TeamAntumbra/glow-hardware/Beta Release/Electronics/AntumbraBetaBoard.jpg

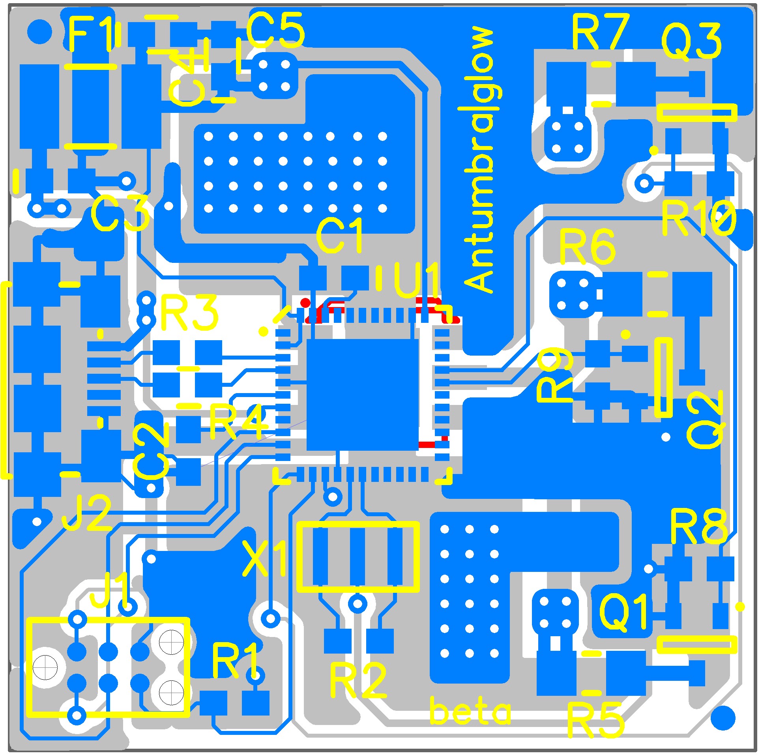
Beta Release/Electronics/AntumbraBetaBoard.jpg
