TeamAntumbra/glow-hardware/Beta Release/Electronics/AntumbraBetaSchematic.jpg

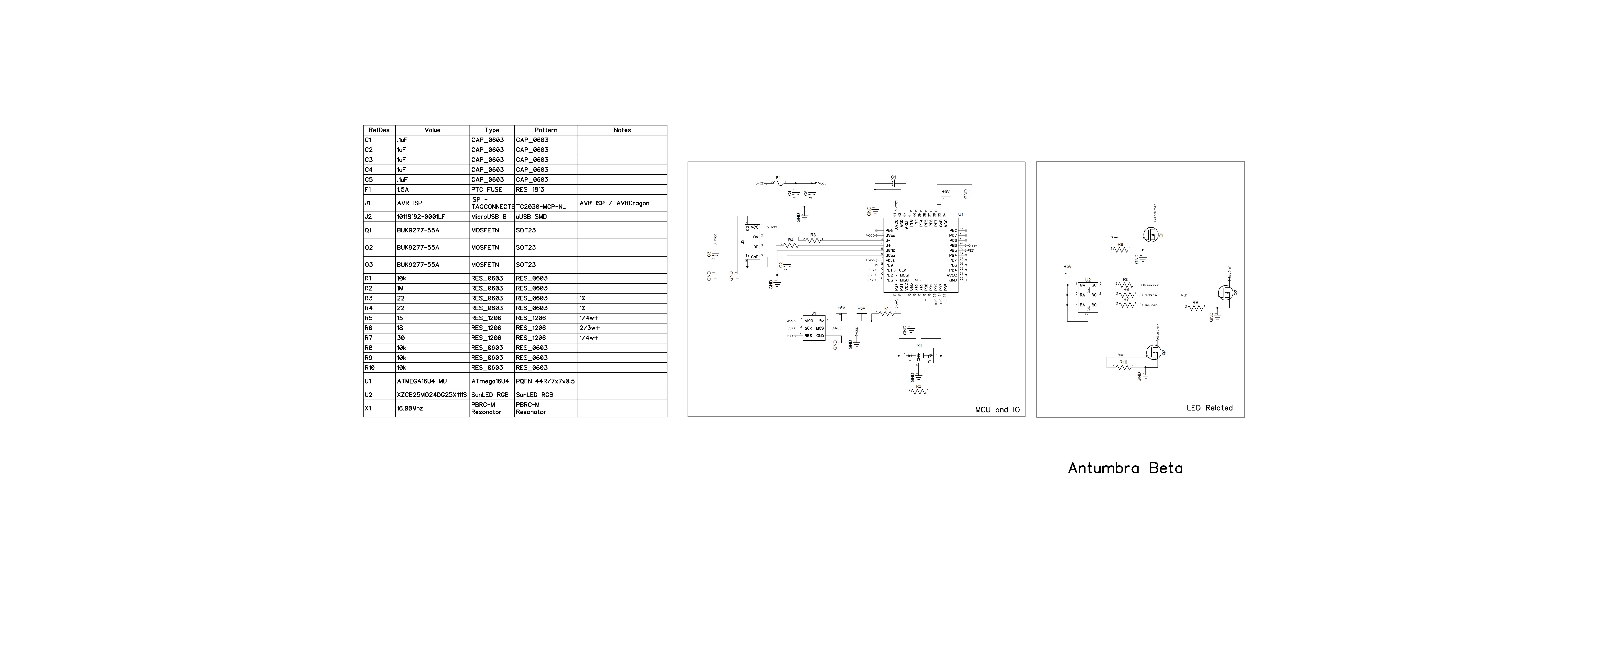
Beta Release/Electronics/AntumbraBetaSchematic.jpg
