TeamAntumbra/glow-hardware/Beta Release/Mechanical Production Files/Back View Hardware.JPG

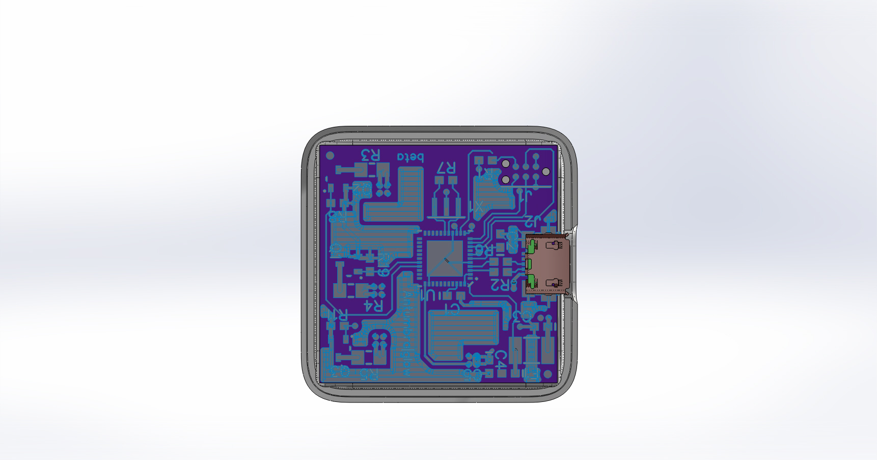
Beta Release/Mechanical Production Files/Back View Hardware.JPG
