TeamAntumbra/glow-hardware/Beta Release/Mechanical Production Files/Side Cutaway Hardware.JPG

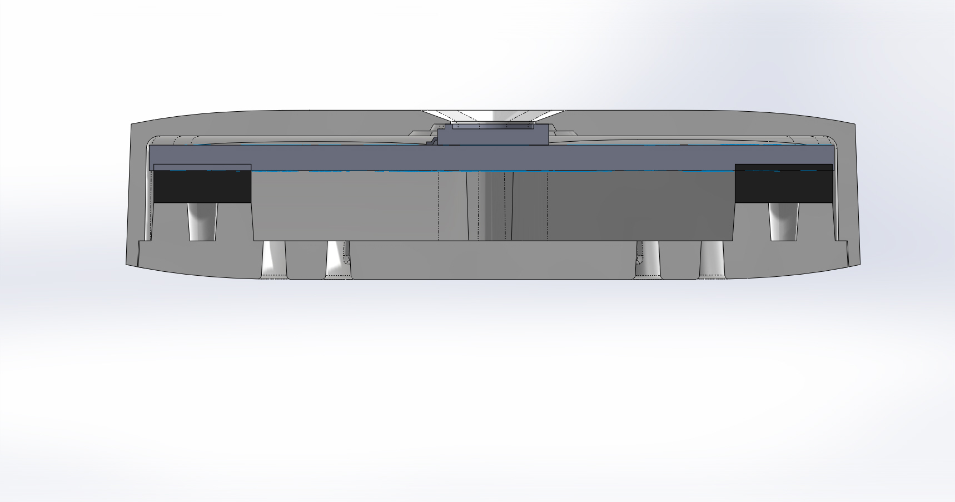
Beta Release/Mechanical Production Files/Side Cutaway Hardware.JPG
