TeamAntumbra/glow-hardware/Beta Release/Mechanical Production Files/Trimetric Hardware.JPG

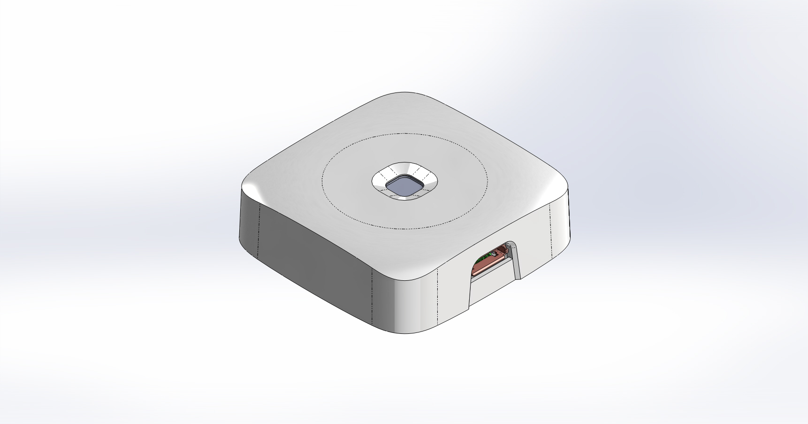
Beta Release/Mechanical Production Files/Trimetric Hardware.JPG
