TeamAntumbra/glow-hardware/Beta Release/Mechanical Production Files/Main Body.STL

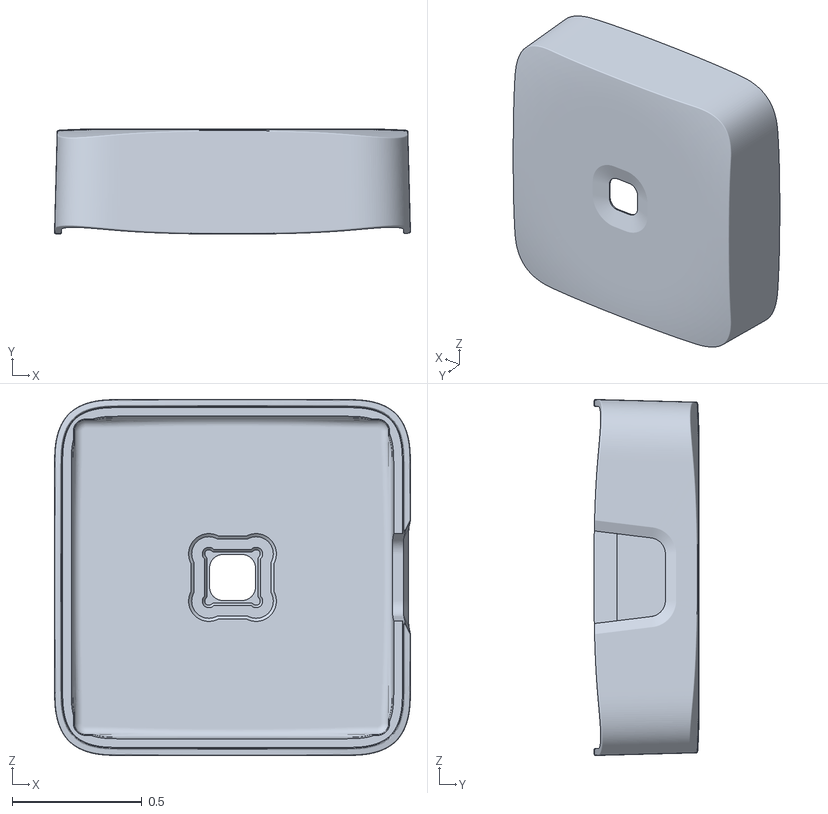
[picture p6: CAD file, 2015-02-19]
Beta Release/Mechanical Production Files/Main Body.STL
1.37 x 0.406 x 1.37
