TeamAntumbra/glow-hardware/Beta Release/Mechanical Production Files/Base.STL

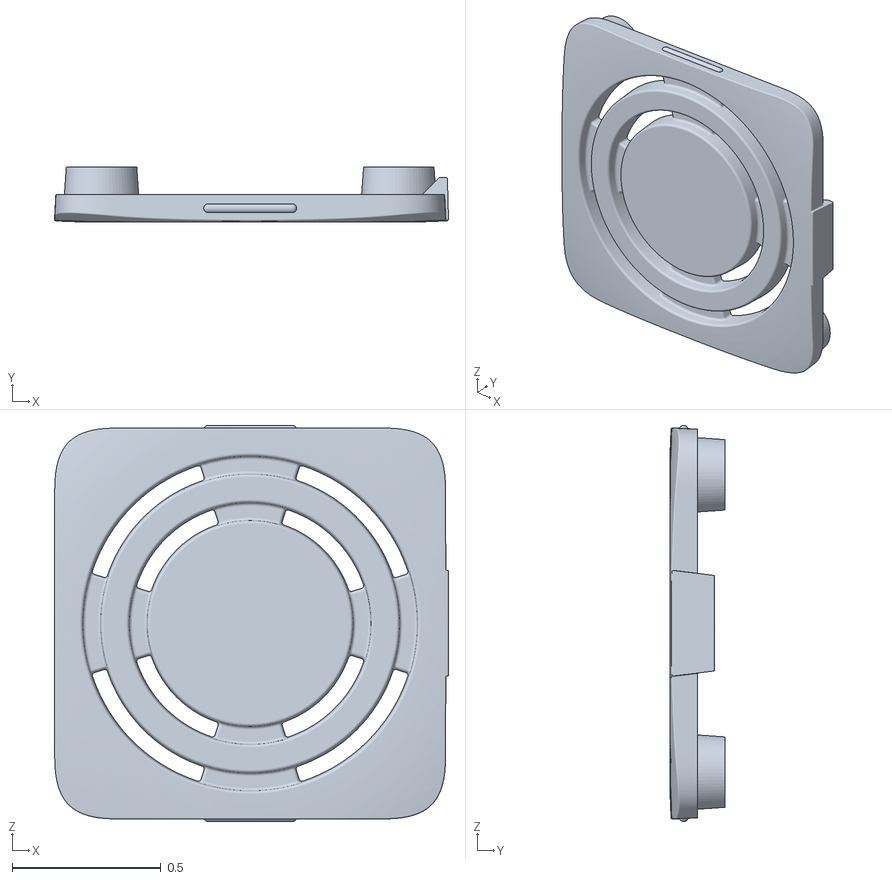
[picture p7: CAD file, 2015-02-19]
Beta Release/Mechanical Production Files/Base.STL
1.33 x 0.187 x 1.33
