TeamAntumbra/glow-hardware/(list of files, drawings)

Other design files:
Beta Release/Electronics/AntumbraBetaProd.dch
Beta Release/Electronics/AntumbraBetaProd.dip
