TeamAntumbra/glow-hardware/(commit log)

2015-02-19 This is the initial hardware commit, complete with beta production files. !
    [AntumbraBeta BOMCSV.csv, AntumbraBetaProd.dch, AntumbraBetaProd.dip, Base.STL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]
2015-02-26 Remove bogus +x permissions. It bothers me.
    [AntumbraBeta BOMCSV.csv, AntumbraBetaProd.dch, AntumbraBetaProd.dip, Base.STL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]
